openfuckorg/handheld_control/README.MD

OpenFuck Wiki https://github.com/openfuckorg/documents/wiki

This is a handheld control module /box for the OpenFUCK (or really anything you care to plug it into).
Designed by the awesome @RuthlessRachel (via FetLife) :D
