openfuckorg/handheld_control/pcb.png

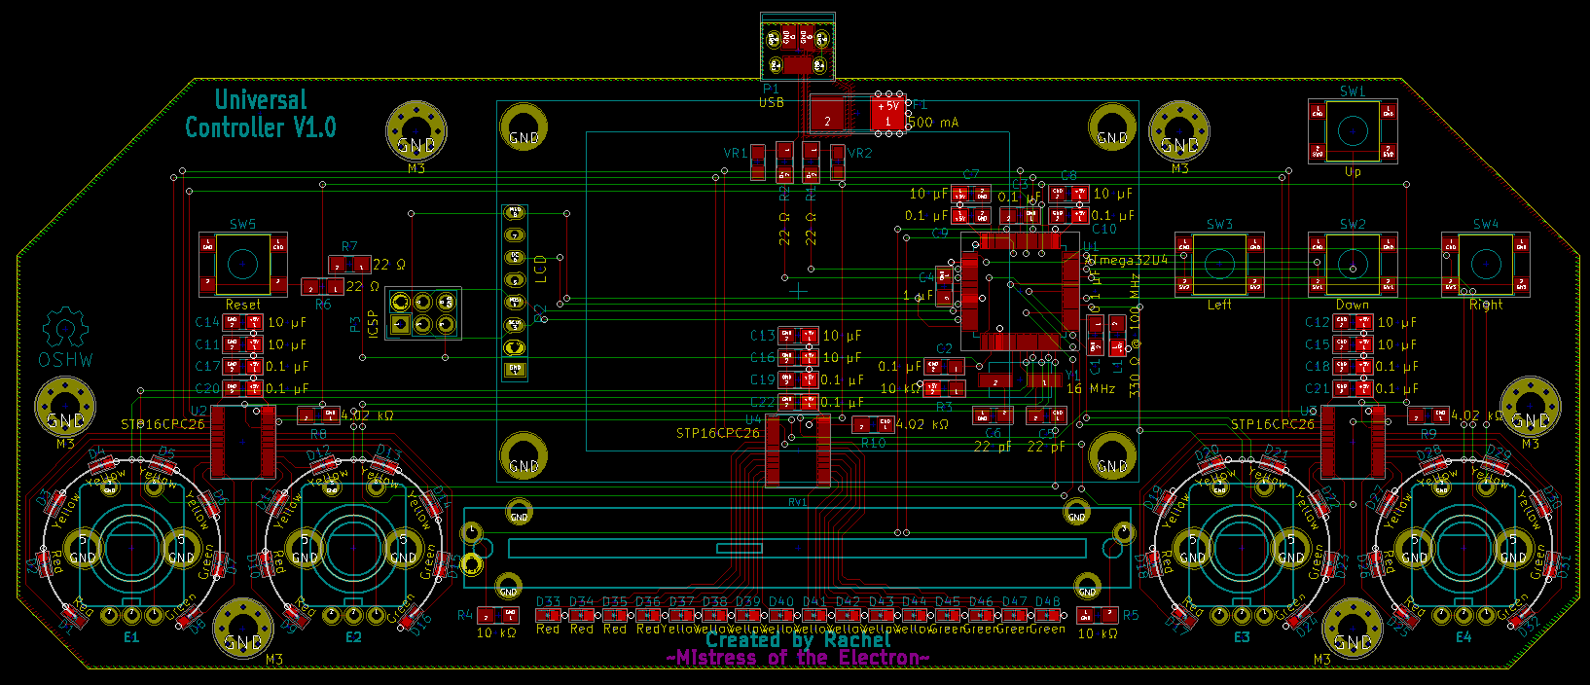
pcb.png
