openfuckorg/handheld_control/controller_parts_list.ods

Component | Name | Quantity | For | Note | RoHS | Manufacturer part # | Manufacturer | Distributor part # | Distributor | Unit price | Extended price | Total
USB micro B connector |  | 1 | Data connection |  | Yes | 10103594-0001LF | Amphenol | 609-4050-1-ND | Digikey | $0.72000 | $0.72 | $76.37
ATMega32u4 |  | 1 | Processing |  | Yes | ATMEGA32U4-AU | Atmel | ATMEGA32U4-AU-ND | Digikey | $6.32000 | $6.32
16 Port shift register LED driver |  | 3 | LED drivers |  | Yes | STP16CPC26PTR | ST | 497-11923-1-ND | Digikey | $0.89000 | $2.67
6 pin ICSP header |  | 1 | Programming |  | Yes | 67997-206HLF | Amphenol | 609-3234-ND | Digikey | $0.31000 | $0.31
2.4” SPI LCD module |  | 1 | User interface | ILI9341 Driver |  |  |  | http://www.ebay.com/itm/2-4-inch-Full-Color-240-320-SPI-TFT-LCD-Display-Module-for-Arduino-Raspberry-Pi-/191843643101 | Ebay | $8.45000 | $8.45
Rotary encoder |  | 4 | User interface | 6mm D shaft | Yes | EVE-VCGJL016B | Panasonic | P12418-ND | Digikey | $2.52000 | $10.08
10 kΩ linear potentiometer |  | 2 | User interface | 60 mm stroke | Yes | PTA6043-2015DPB103 | Bourns | PTA6043-2015DPB103-ND | Digikey | $1.60000 | $3.20
Tactile switch |  | 5 | User interface |  | Yes | B3S-1000 | Omron | SW415-ND | Digikey | $0.76000 | $3.80
Red LED, 0603 |  | 12 | User interface |  | Yes | XZMDK53W-8 | SunLED | 1497-1169-1-ND | Digikey | $0.33000 | $3.96
Yellow LED, 0603 |  | 24 | User interface |  | Yes | XZMYK53W-8 | SunLED | 1497-1193-1-ND | Digikey | $0.33000 | $7.92
Green LED, 0603 |  | 12 | User interface |  | Yes | XZVG53W-8 | SunLED | 1497-1215-1-ND | Digikey | $0.35100 | $4.21
10 uF capacitor, 16 V, 0805 |  | 8 | Decoupling |  | Yes | GRM21BR61C106KE15L | Murata | 490-3886-1-ND | Digikey | $0.08720 | $0.70
1 uF capacitor, 25 V, 0805 |  | 1 | Decoupling |  | Yes | CL21B105KAFNNNE | Samsung | 1276-1066-1-ND | Digikey | $0.11000 | $0.11
0.1 uF capacitor, 0805 |  | 9 | Decoupling |  | Yes | CL21B104KACNNNC | Samsung | 1276-1099-1-ND | Digikey | $0.02040 | $0.18
22 pF capacitor, 0805 |  | 2 | Clock |  | Yes | C0805C220J5GACTU | Kemet | 399-1113-1-ND | Digikey | $0.02240 | $0.04
Crystal, 16 MHz |  | 1 | Clock |  | Yes | ABLS7M2-16.000MHZ-D-2Y-T | Abracon | 535-12830-1-ND | Digikey | $0.38000 | $0.38
22 Ω resistor, 0805 |  | 2 | USB interface |  | Yes | RC0805FR-0722RL | Yageo | 311-22.0CRCT-ND | Digikey | $0.10000 | $0.20
4.02 kΩ resistor, 0805 |  | 3 | LED current set |  | Yes | RC0805FR-074K02L | Yageo | 311-4.02KCRCT-ND | Digikey | $0.10000 | $0.30
10 kΩ resistor, 0805 |  | 3 | Potentiometer divider |  | Yes | RC0805FR-0710KL | Yageo | 311-10.0KCRCT-ND | Digikey | $0.10000 | $0.30
330 Ω @ 100 MHz ferrite chip, 0805 |  | 1 | Power filtering |  | Yes | BLM21PG331SN1D | Murata | 490-5988-1-ND | Digikey | $0.12000 | $0.12
500 mA PTC fuse, 1812 | F1 | 1 | Circuit protection |  | Yes | MF-MSMF050-2 | Bourns | MF-MSMF050-2CT-ND | Digikey | $0.22000 | $0.22
MOV, 0603 | VR1,2 | 2 | Circuit protection |  | Yes | CG0603MLC-05LE | Bourns | CG0603MLC-05LECT-ND | Digikey | $0.22000 | $0.44
3.18 mm board spacer |  | 4 | Holding LCD |  | Yes | 8879 | Keystone | 36-8879-ND | Digikey | $0.21000 | $0.84
M3 * 9.53 mm threaded inserts (10) |  | 2 | Holding screws | Brass | Yes |  |  | 95631A050 | McMaster | $4.09000 | $8.18
M3 * 12 mm flat head cap screw (100) |  | 1 | Securing top cover | 18-8 Stainless | Yes |  |  | 92125A132 | McMaster | $6.00000 | $6.00
M3 * 10 mm socket head cap screw (100) |  | 1 | Securing PCB | 18-8 Stainless | Yes |  |  | 91292A113 | McMaster | $4.40000 | $4.40
M3 lock washer (100) |  | 1 | Securing PCB | 18-8 Stainless | Yes |  |  | 93925A240 | McMaster | $2.31000 | $2.31
