openfuckorg/handheld_control/controller.pdf

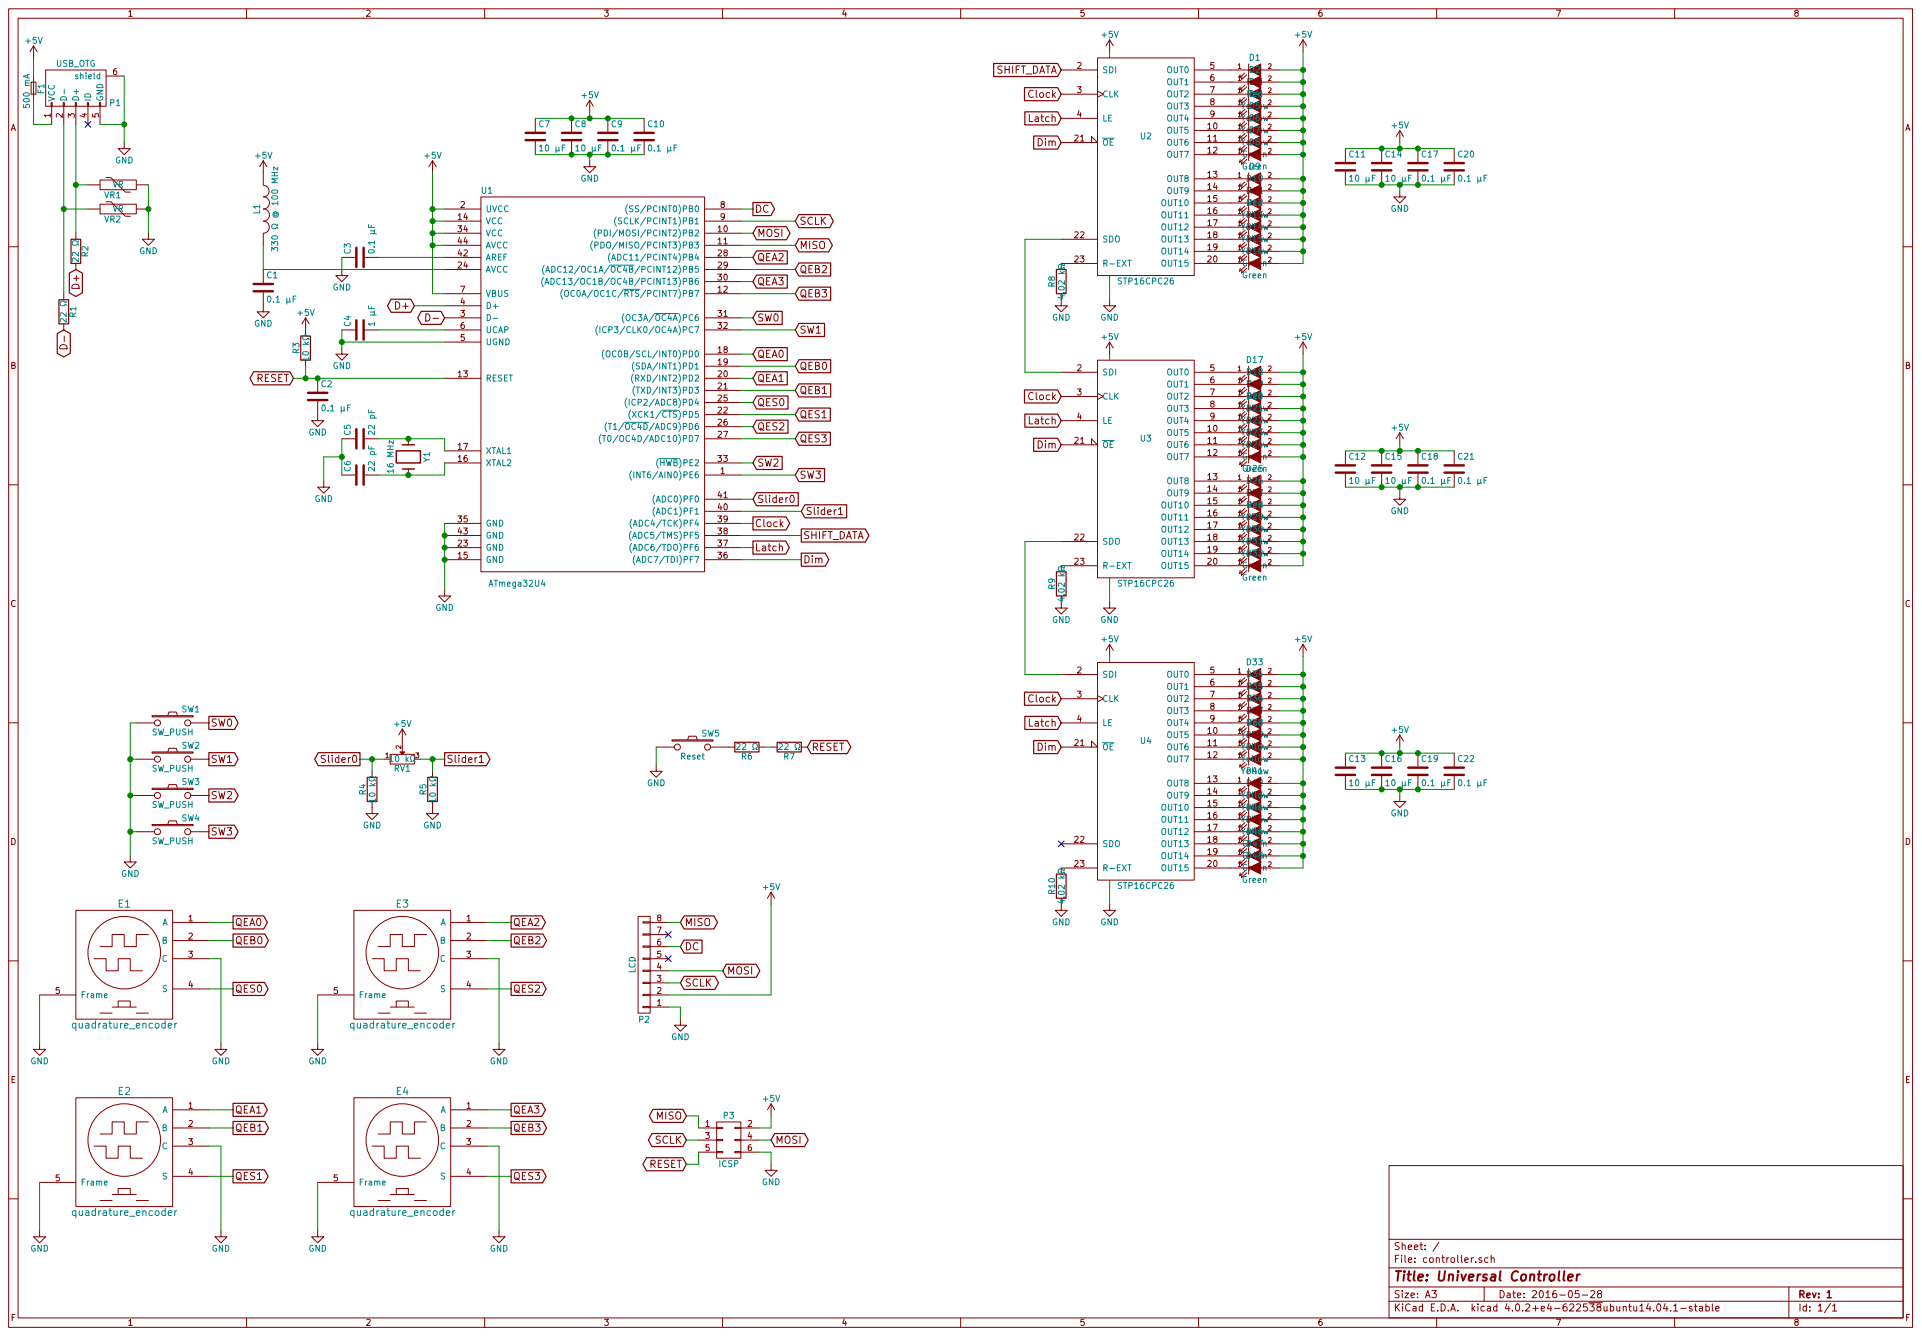
[picture p2: page 1]

Id: 1/1 Title: Universal Controller File: controller.sch Sheet: /
