openfuckorg/handheld_control/pcb.pdf

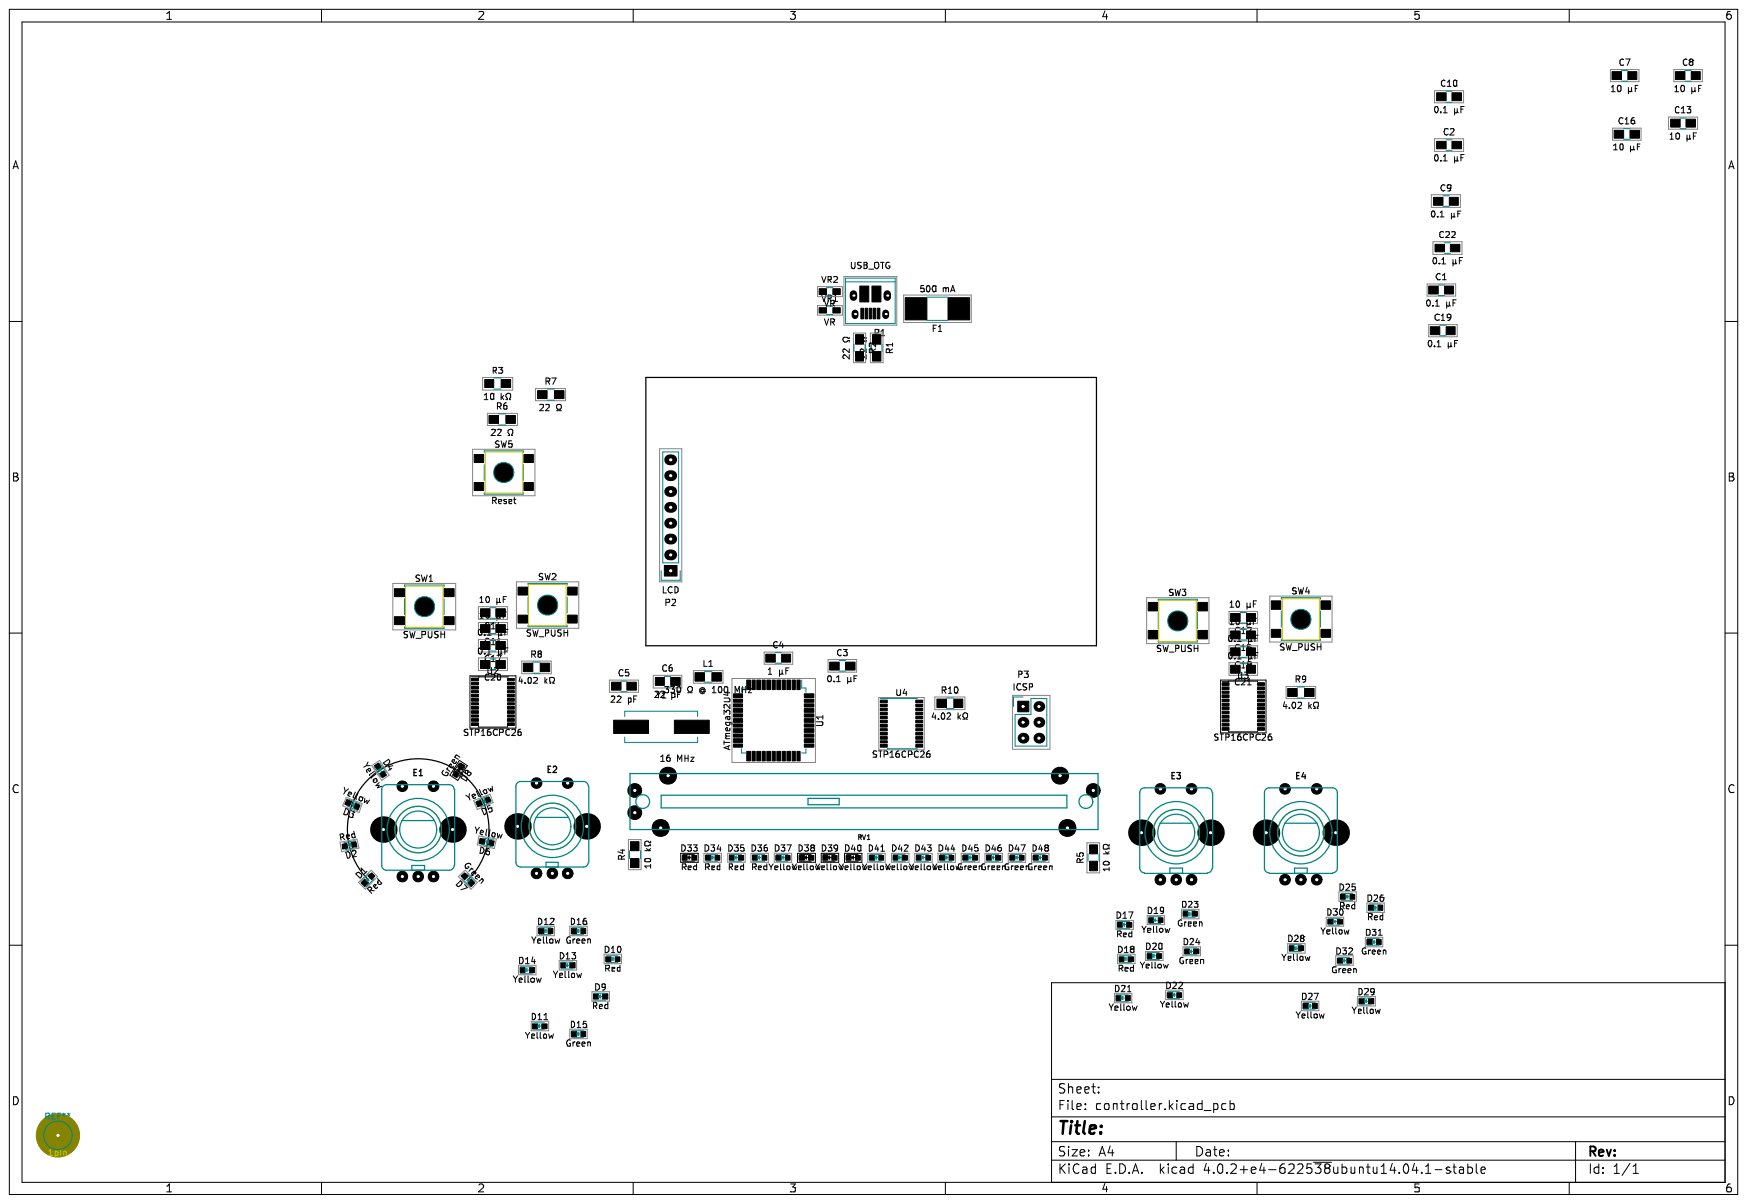
[picture p3: page 1]
