openfuckorg/handheld_control/(list of files, drawings)

Other design files:
controller.dsn
