openfuckorg/handheld_control/controller.kicad_pcb

## KiCad design controller.kicad_pcb (2016-09-11)

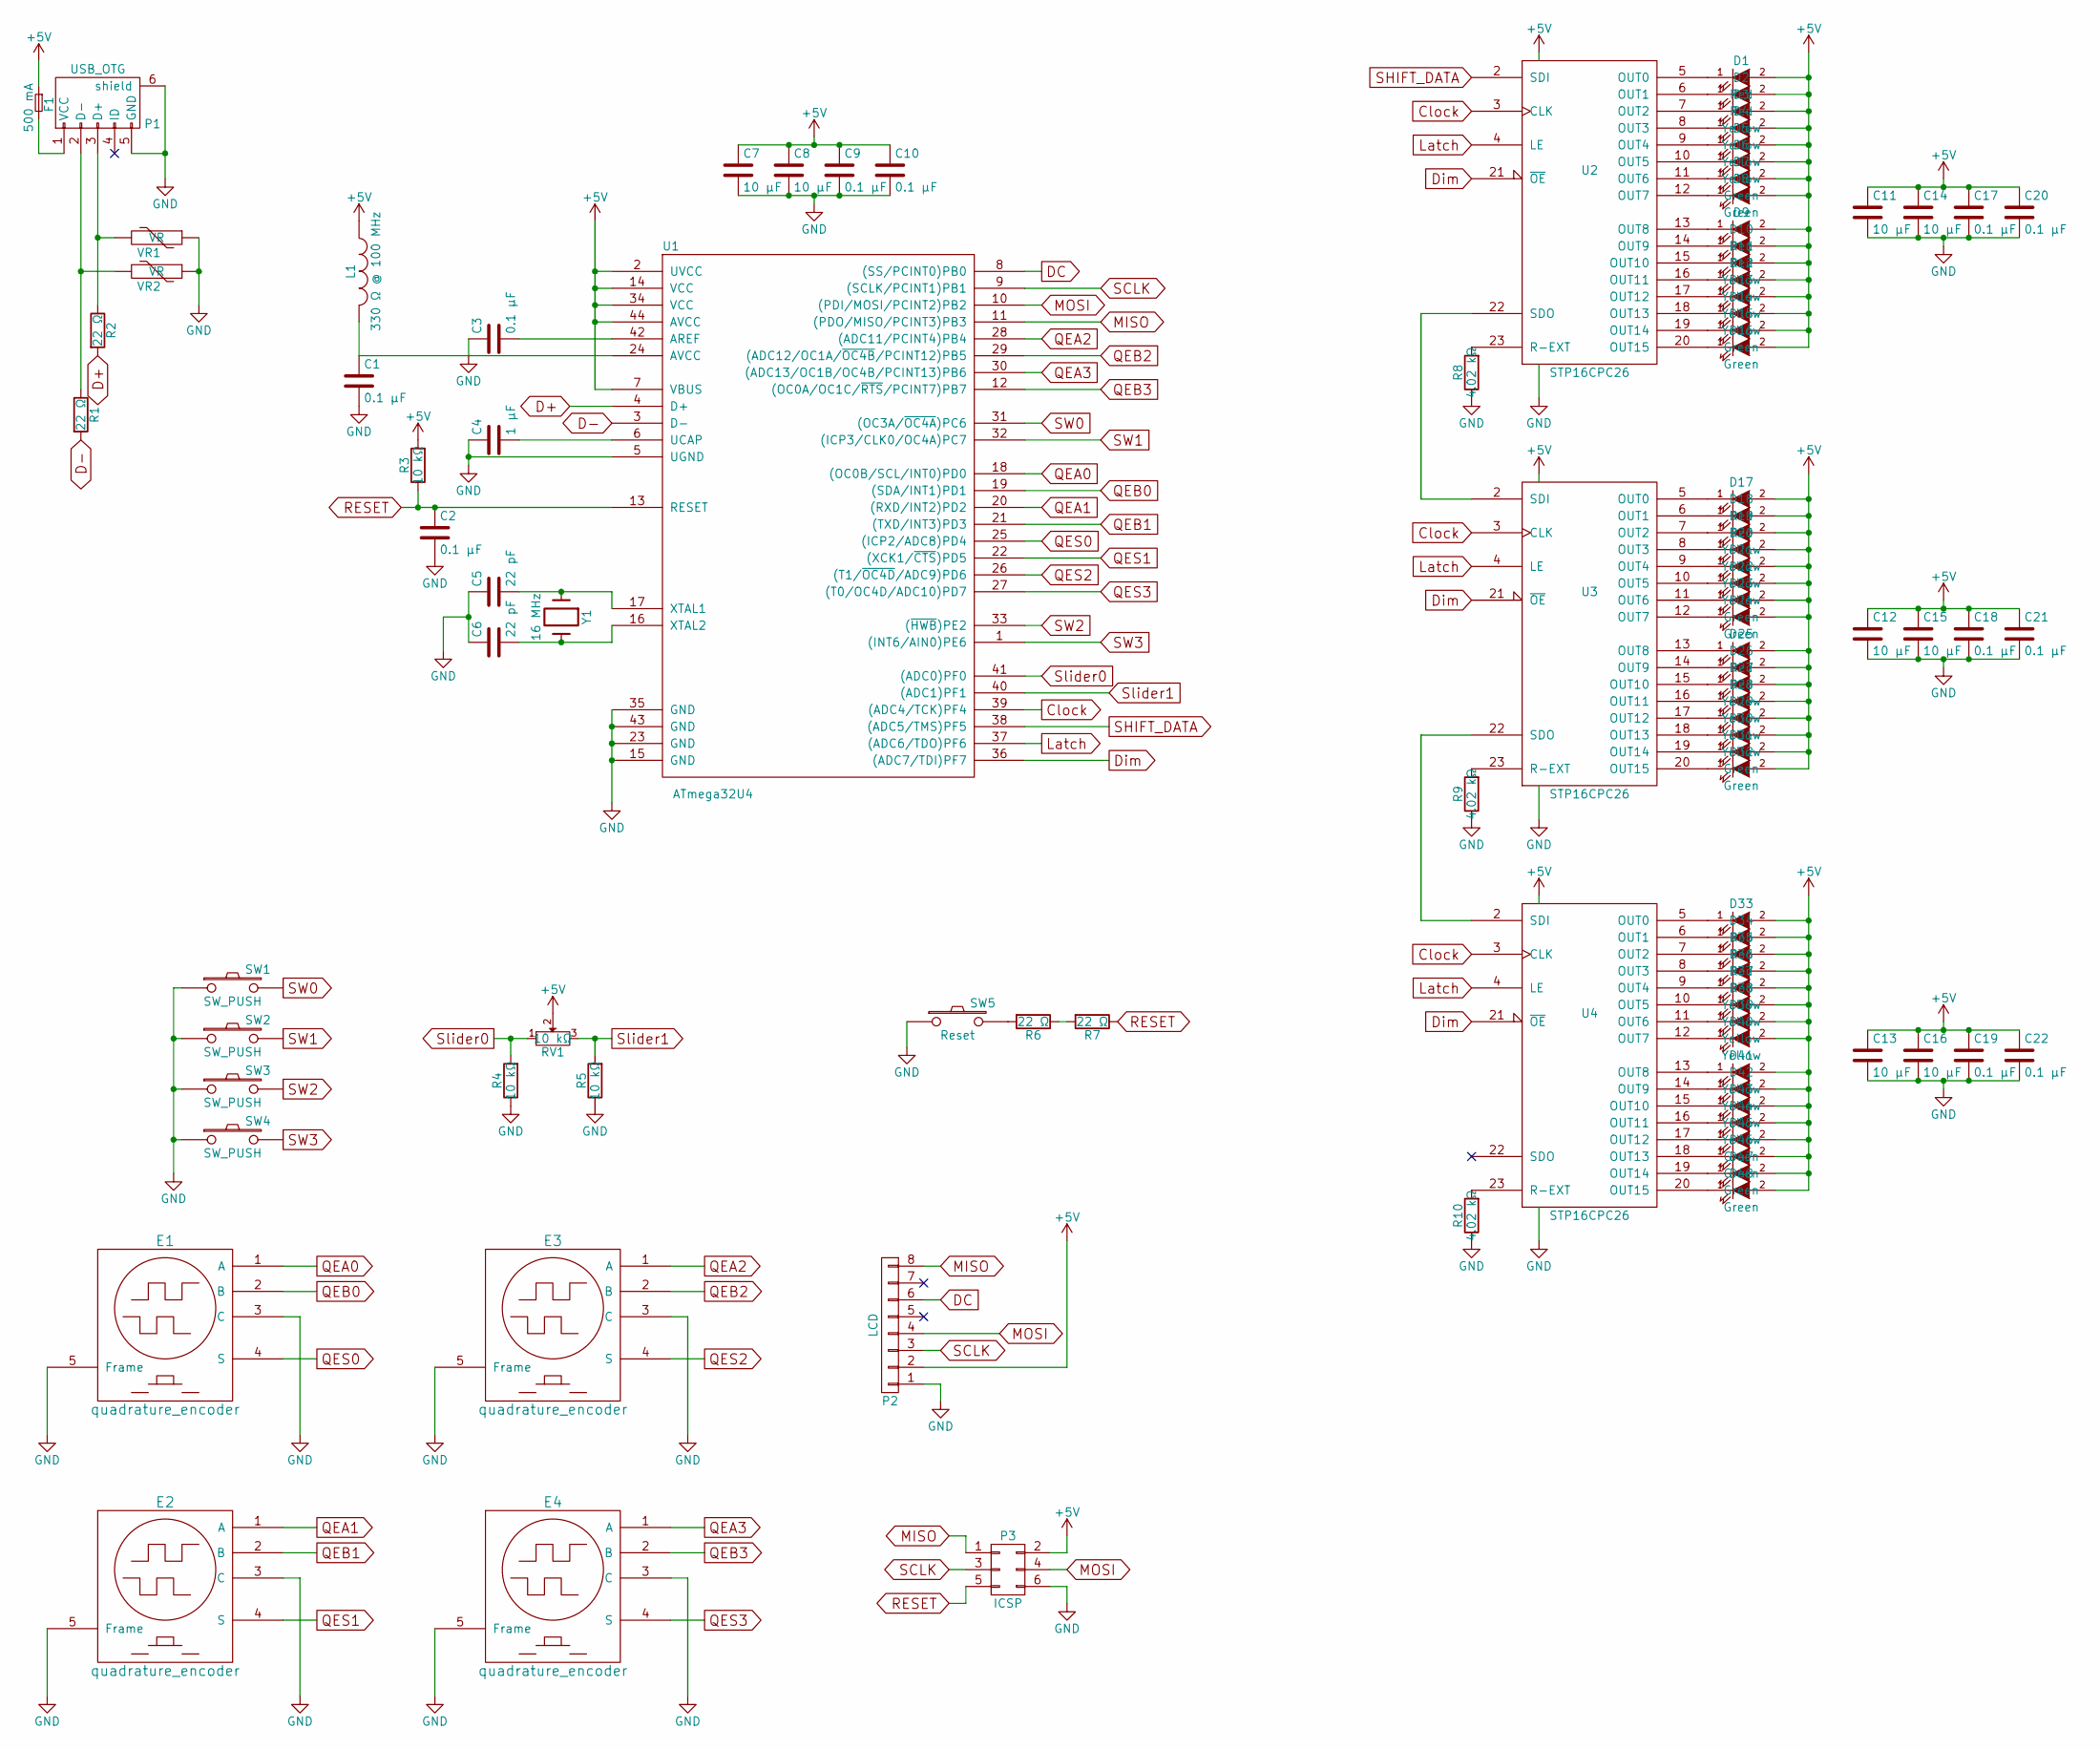
[picture p4: schematic controller.sch, Universal Controller]

Parts:
C1, C2, C3, C9, C10, C17, C18, C19, C20, C21, C22: 0.1 μF; C_0805_HandSoldering
C4: 1 μF; C_0805_HandSoldering
C5, C6: 22 pF; C_0805_HandSoldering
C7, C8, C11, C12, C13, C14, C15, C16: 10 μF; C_0805_HandSoldering
D1, D2, D9, D10, D17, D18, D25, D26, D33, D34, D35, D36: Red; LED_0603
D3, D4, D5, D6, D11, D12, D13, D14, D19, D20, D21, D22, D27, D28, D29, D30, D37, D38, D39, D40, D41, D42, D43, D44: Yellow; LED_0603
D7, D8, D15, D16, D23, D24, D31, D32, D45, D46, D47, D48: Green; LED_0603
E1, E2, E3, E4: quadrature_encoder; eve-vcgjl016b
F1: 500 mA; R_1812_HandSoldering
L1: 330 Ω @ 100 MHz; R_0805_HandSoldering
P1: USB_OTG; USB_Micro-B_10103594-0001LF
P2: LCD; 2.4_lcd
P3: ICSP; Pin_Header_Straight_2x03
R1, R2, R6, R7: 22 Ω; R_0805_HandSoldering
R3, R4, R5: 10 kΩ; R_0805_HandSoldering
R8, R9, R10: 4.02 kΩ; R_0805_HandSoldering
RV1: 10 kΩ; bourns-pta6043_60mm-slide-pot
SW1, SW2, SW3, SW4: SW_PUSH; SW_SPST_B3S-1000
SW5: Reset; SW_SPST_B3S-1000
U1: ATmega32U4; TQFP-44_10x10mm_Pitch0.8mm
U2, U3, U4: STP16CPC26; TSSOP-24_4.4x7.8mm_Pitch0.65mm
VR1, VR2: VR; R_0603_HandSoldering
Y1: 16 MHz; abls7m2_crystal

Connections:
+5V: C7.1, C8.1, C9.1, C10.1, C11.1, C12.1, C13.1, C14.1, C15.1, C16.1, C17.1, C18.1, C19.1, C20.1, C21.1, C22.1, D1.2 (A), D2.2 (A), D3.2 (A), D4.2 (A), D5.2 (A), D6.2 (A), D7.2 (A), D8.2 (A), D9.2 (A), D10.2 (A), D11.2 (A), D12.2 (A), D13.2 (A), D14.2 (A), D15.2 (A), D16.2 (A), D17.2 (A), D18.2 (A), D19.2 (A), D20.2 (A), D21.2 (A), D22.2 (A), D23.2 (A), D24.2 (A), D25.2 (A), D26.2 (A), D27.2 (A), D28.2 (A), D29.2 (A), D30.2 (A), D31.2 (A), D32.2 (A), D33.2 (A), D34.2 (A), D35.2 (A), D36.2 (A), D37.2 (A), D38.2 (A), D39.2 (A), D40.2 (A), D41.2 (A), D42.2 (A), D43.2 (A), D44.2 (A), D45.2 (A), D46.2 (A), D47.2 (A), D48.2 (A), F1.1, L1.1, P2.2, P3.2, R3.2, RV1.2, U1.2 (UVCC), U1.7 (VBUS), U1.14 (VCC), U1.34 (VCC), U1.44 (AVCC), U2.24 (VDD), U3.24 (VDD), U4.24 (VDD)
Clock: U1.39 ((ADC4/TCK)PF4), U2.3 (CLK), U3.3 (CLK), U4.3 (CLK)
D+: R2.2, U1.4 (D+)
D-: R1.2, U1.3 (D-)
DC: P2.6, U1.8 ((SS/PCINT0)PB0)
Dim: U1.36 ((ADC7/TDI)PF7), U2.21 (~OE), U3.21 (~OE), U4.21 (~OE)
Latch: U1.37 ((ADC6/TDO)PF6), U2.4 (LE), U3.4 (LE), U4.4 (LE)
MISO: P2.8, P3.1, U1.11 ((PDO/MISO/PCINT3)PB3)
MOSI: P2.4, P3.4, U1.10 ((PDI/MOSI/PCINT2)PB2)
unnamed: C3.2, U1.42 (AREF)
unnamed: C4.2, U1.6 (UCAP)
unnamed: C5.2, U1.17 (XTAL1), Y1.1
unnamed: C6.2, U1.16 (XTAL2), Y1.2
unnamed: D1.1 (K), U2.5 (OUT0)
unnamed: D2.1 (K), U2.6 (OUT1)
unnamed: D3.1 (K), U2.7 (OUT2)
unnamed: D4.1 (K), U2.8 (OUT3)
unnamed: D5.1 (K), U2.9 (OUT4)
unnamed: D6.1 (K), U2.10 (OUT5)
unnamed: D7.1 (K), U2.11 (OUT6)
unnamed: D8.1 (K), U2.12 (OUT7)
unnamed: D9.1 (K), U2.13 (OUT8)
unnamed: D10.1 (K), U2.14 (OUT9)
unnamed: D11.1 (K), U2.15 (OUT10)
unnamed: D12.1 (K), U2.16 (OUT11)
unnamed: D13.1 (K), U2.17 (OUT12)
unnamed: D14.1 (K), U2.18 (OUT13)
unnamed: D15.1 (K), U2.19 (OUT14)
unnamed: D16.1 (K), U2.20 (OUT15)
unnamed: D17.1 (K), U3.5 (OUT0)
unnamed: D18.1 (K), U3.6 (OUT1)
unnamed: D19.1 (K), U3.7 (OUT2)
unnamed: D20.1 (K), U3.8 (OUT3)
unnamed: D21.1 (K), U3.9 (OUT4)
unnamed: D22.1 (K), U3.10 (OUT5)
unnamed: D23.1 (K), U3.11 (OUT6)
unnamed: D24.1 (K), U3.12 (OUT7)
unnamed: D25.1 (K), U3.13 (OUT8)
unnamed: D26.1 (K), U3.14 (OUT9)
unnamed: D27.1 (K), U3.15 (OUT10)
unnamed: D28.1 (K), U3.16 (OUT11)
unnamed: D29.1 (K), U3.17 (OUT12)
unnamed: D30.1 (K), U3.18 (OUT13)
unnamed: D31.1 (K), U3.19 (OUT14)
unnamed: D32.1 (K), U3.20 (OUT15)
unnamed: D33.1 (K), U4.5 (OUT0)
unnamed: D34.1 (K), U4.6 (OUT1)
unnamed: D35.1 (K), U4.7 (OUT2)
unnamed: D36.1 (K), U4.8 (OUT3)
unnamed: D37.1 (K), U4.9 (OUT4)
unnamed: D38.1 (K), U4.10 (OUT5)
unnamed: D39.1 (K), U4.11 (OUT6)
unnamed: D40.1 (K), U4.12 (OUT7)
unnamed: D41.1 (K), U4.13 (OUT8)
unnamed: D42.1 (K), U4.14 (OUT9)
unnamed: D43.1 (K), U4.15 (OUT10)
unnamed: D44.1 (K), U4.16 (OUT11)
unnamed: D45.1 (K), U4.17 (OUT12)
unnamed: D46.1 (K), U4.18 (OUT13)
unnamed: D47.1 (K), U4.19 (OUT14)
unnamed: D48.1 (K), U4.20 (OUT15)
unnamed: F1.2, P1.1 (VCC)
unnamed: P1.2 (D-), R1.1, VR2.2
unnamed: P1.3 (D+), R2.1, VR1.2
unnamed: R6.1, R7.2
unnamed: R6.2, SW5.2
unnamed: R8.2, U2.23 (R-EXT)
unnamed: R9.2, U3.23 (R-EXT)
unnamed: R10.2, U4.23 (R-EXT)
unnamed: U2.22 (SDO), U3.2 (SDI)
unnamed: U3.22 (SDO), U4.2 (SDI)
QEA0: E1.1 (A), U1.18 ((OC0B/SCL/INT0)PD0)
QEA1: E2.1 (A), U1.20 ((RXD/INT2)PD2)
QEA2: E3.1 (A), U1.28 ((ADC11/PCINT4)PB4)
QEA3: E4.1 (A), U1.30 ((ADC13/OC1B/OC4B/PCINT13)PB6)
QEB0: E1.2 (B), U1.19 ((SDA/INT1)PD1)
QEB1: E2.2 (B), U1.21 ((TXD/INT3)PD3)
QEB2: E3.2 (B), U1.29 ((ADC12/OC1A/~OC4B~/PCINT12)PB5)
QEB3: E4.2 (B), U1.12 ((OC0A/OC1C/~RTS~/PCINT7)PB7)
QES0: E1.4 (S), U1.25 ((ICP2/ADC8)PD4)
QES1: E2.4 (S), U1.22 ((XCK1/~CTS~)PD5)
QES2: E3.4 (S), U1.26 ((T1/~OC4D~/ADC9)PD6)
QES3: E4.4 (S), U1.27 ((T0/OC4D/ADC10)PD7)
RESET: C2.1, P3.5, R3.1, R7.1, U1.13 (RESET)
SCLK: P2.3, P3.3, U1.9 ((SCLK/PCINT1)PB1)
SHIFT_DATA: U1.38 ((ADC5/TMS)PF5), U2.2 (SDI)
SW0: SW1.2, U1.31 ((OC3A/~OC4A~)PC6)
SW1: SW2.2, U1.32 ((ICP3/CLK0/OC4A)PC7)
SW2: SW3.2, U1.33 ((~HWB~)PE2)
SW3: SW4.2, U1.1 ((INT6/AIN0)PE6)
Slider0: R4.2, RV1.1, U1.41 ((ADC0)PF0)
Slider1: R5.2, RV1.3, U1.40 ((ADC1)PF1)

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
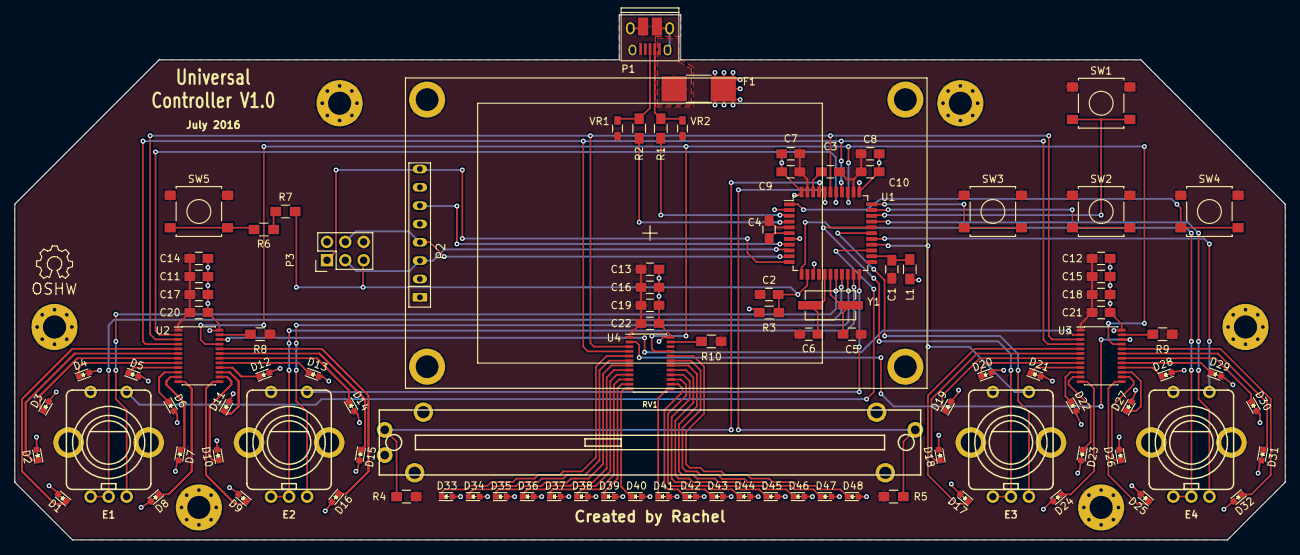
[picture p5: board controller.kicad_pcb from above]

Board: 2 copper layers, 176.0 x 72.8 mm, 102 parts (0 on the bottom side), 94 nets.
